MihaelaGadzhalova707/Diploma_Work/Presentation.pptx

## Автоматизация на аквариум

Представена от
Михаела Гаджалова
12б клас

## Идея на проекта

- Какъв проблем решава?
- Какво покрива?
- С какво е по-добро от това на пазара?

## От къде дойде идеята?

- Кафемашината по КАРХ
- Проект, свързан с автоматизацията на дома
- Моите домашни рибки

## Блокова схема на проекта

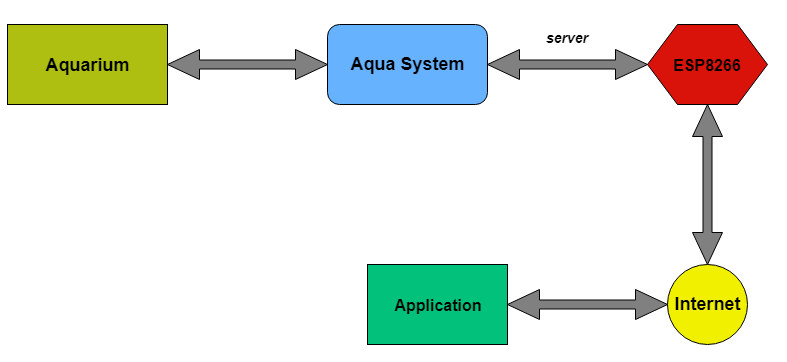
[picture p1: figure]

## Механика на помпата и клапаните

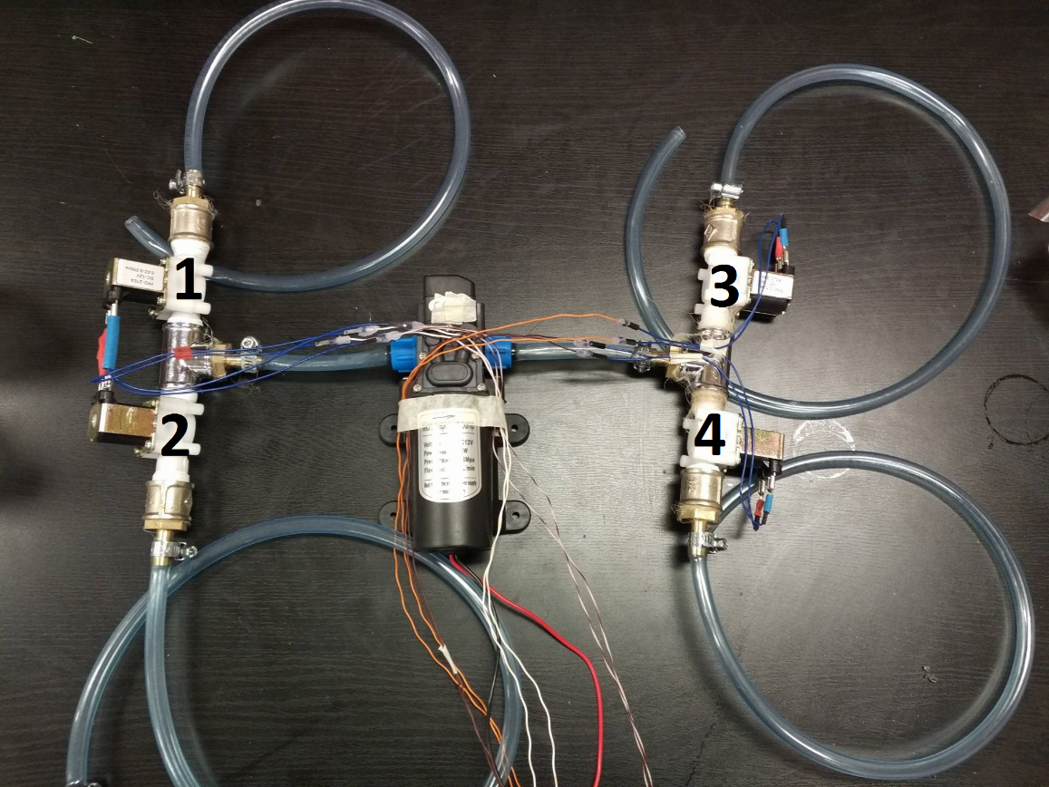
[picture p2: figure]
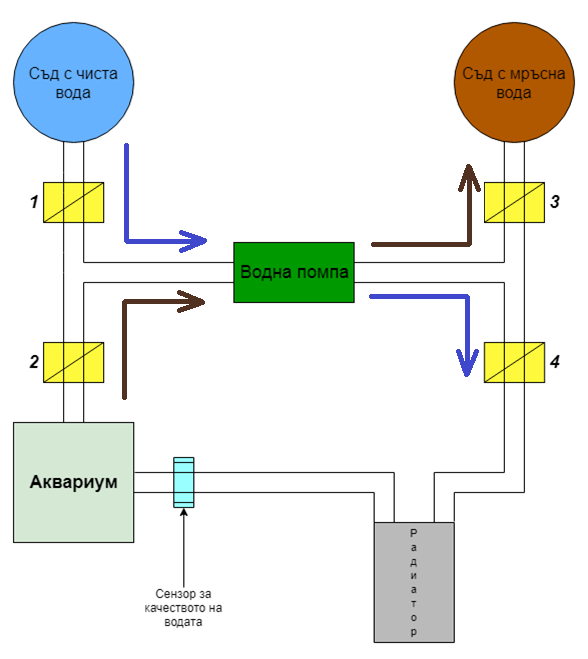
[picture p3: figure]

## Принципни електрически схеми

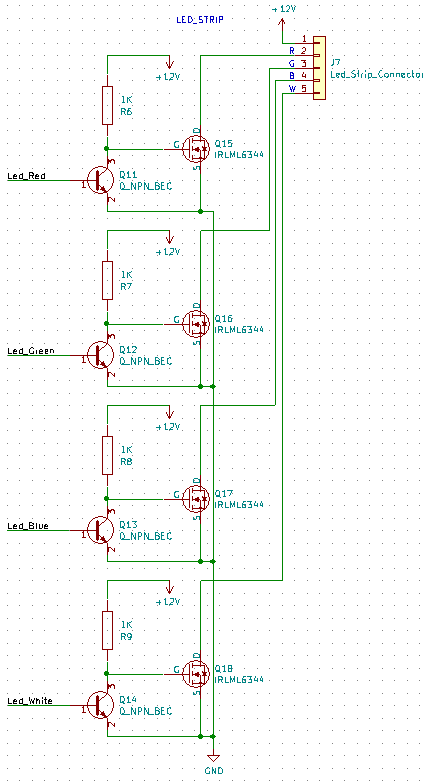
[picture p4: figure]

Светодиодна лента

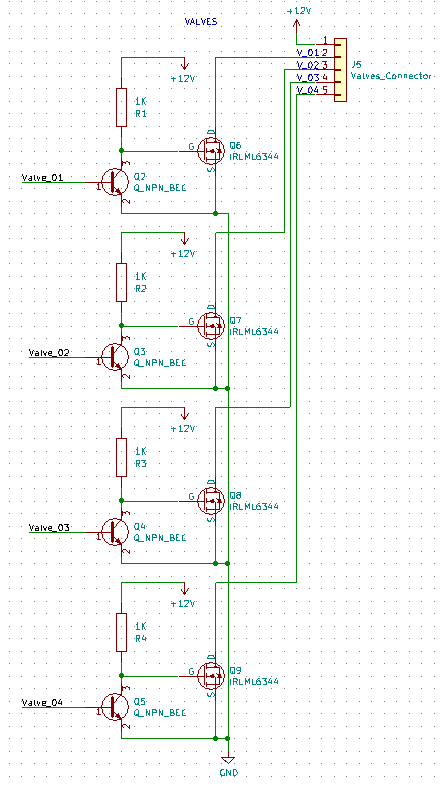
[picture p5: figure]

Клапани

## Принципни електрически схеми

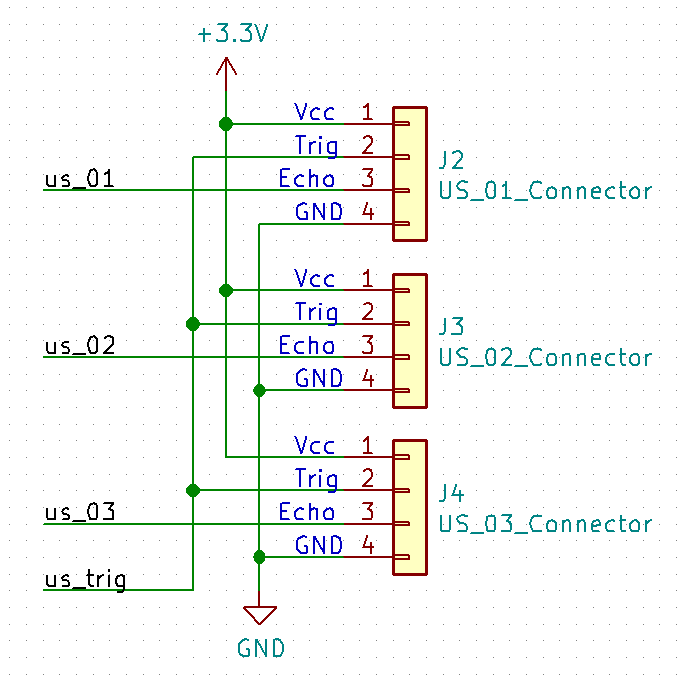
[picture p6: figure]

Ултразвукови сензори

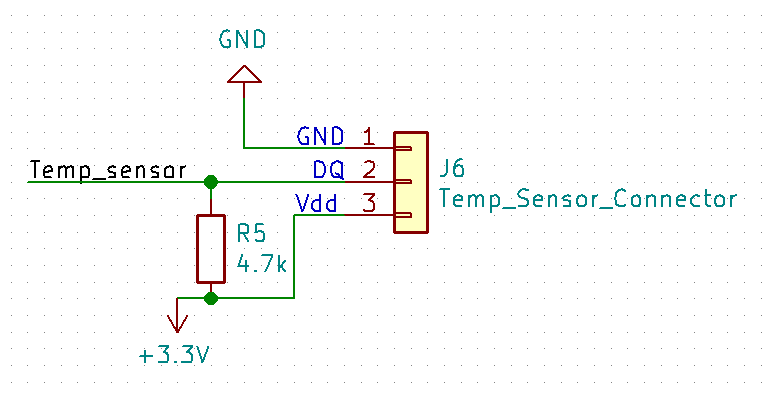
[picture p7: figure]

Сензор за температурата

## Графичен оригинал на печатната платка

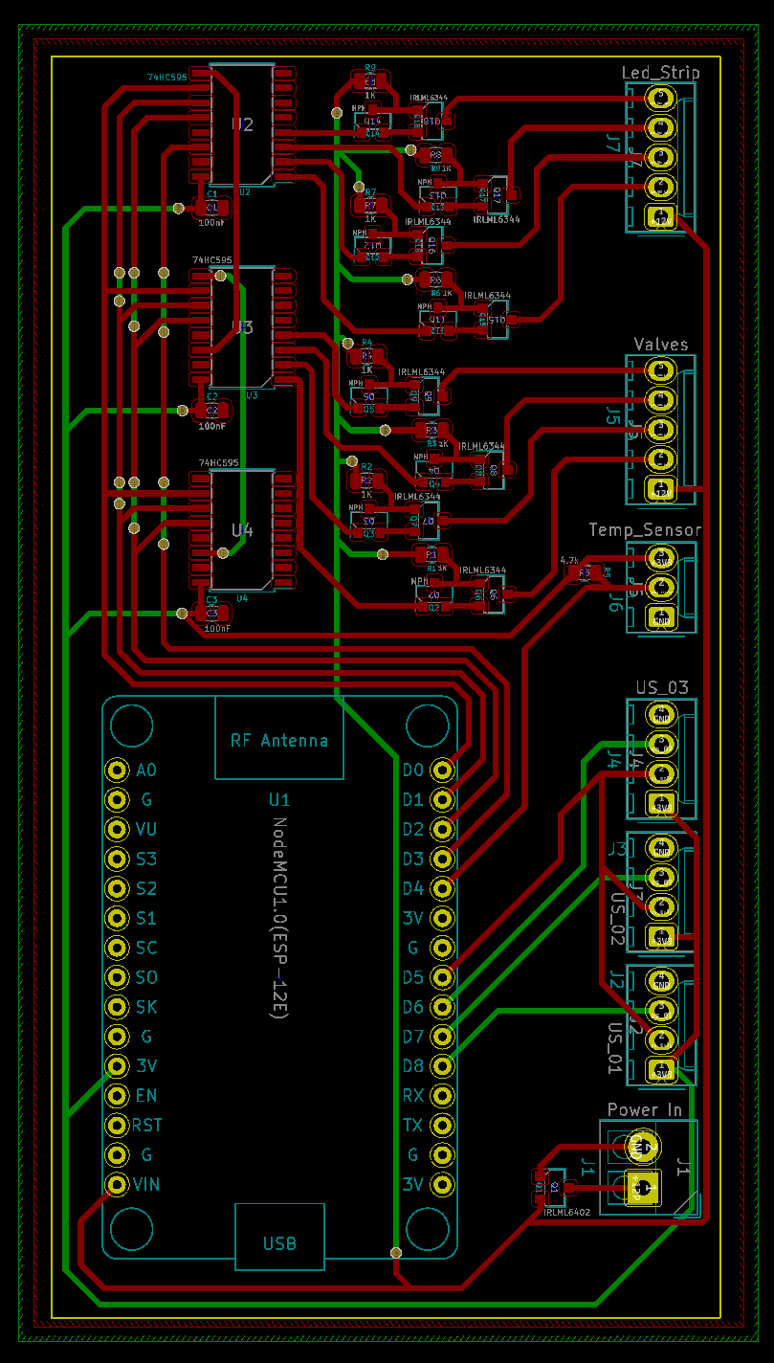
[picture p8: figure]
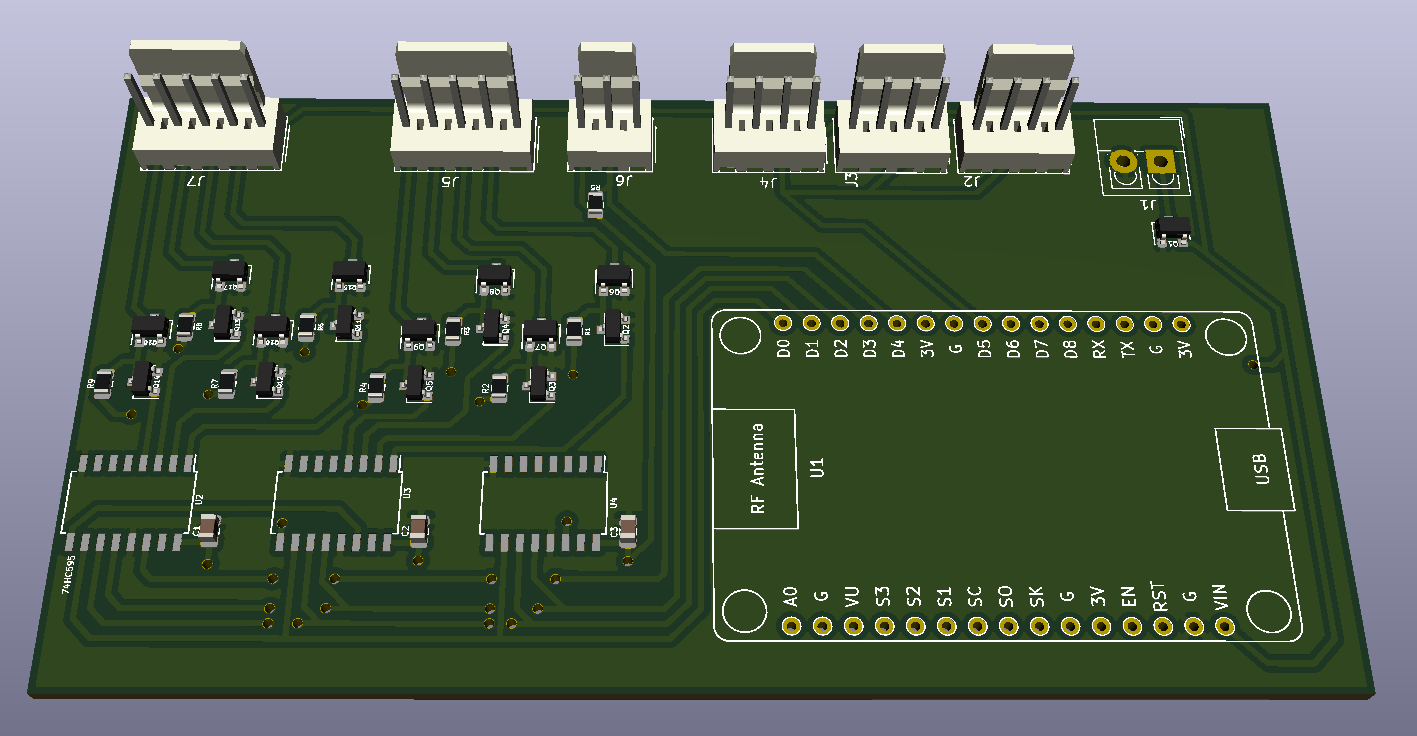
[picture p9: figure]

3D View

## Блокова схема на софтуера

## Свързване с хардуера

## Възникнали проблеми

- Слабо налягане на първата помпа
- Влизане на въдух по маркучите към помпата
- Стабилизиране на ултразвуковите сензори
- Изгорял микроконтролер
- Изгаряне на първата платка

## Бъдещо развитие

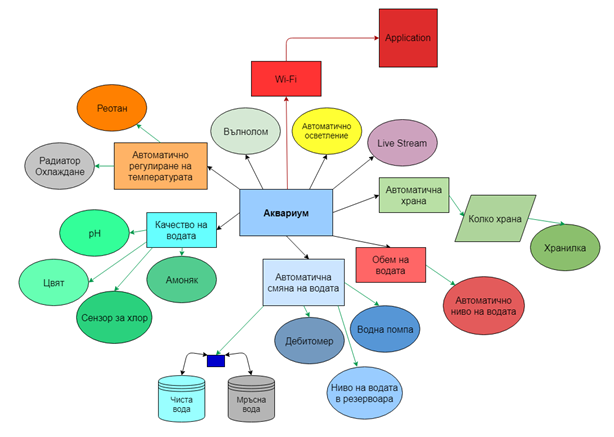
[picture p10: figure]

- Автоматизирана хранилка
- Следене качеството на водата
- Следене pH
- Затопляне на водата
- Live stream

## Slide 13

ДЕМО
