MihaelaGadzhalova707/Diploma_Work/shema/shema.kicad_pcb

## KiCad design shema/shema.kicad_pcb (2019-04-17)

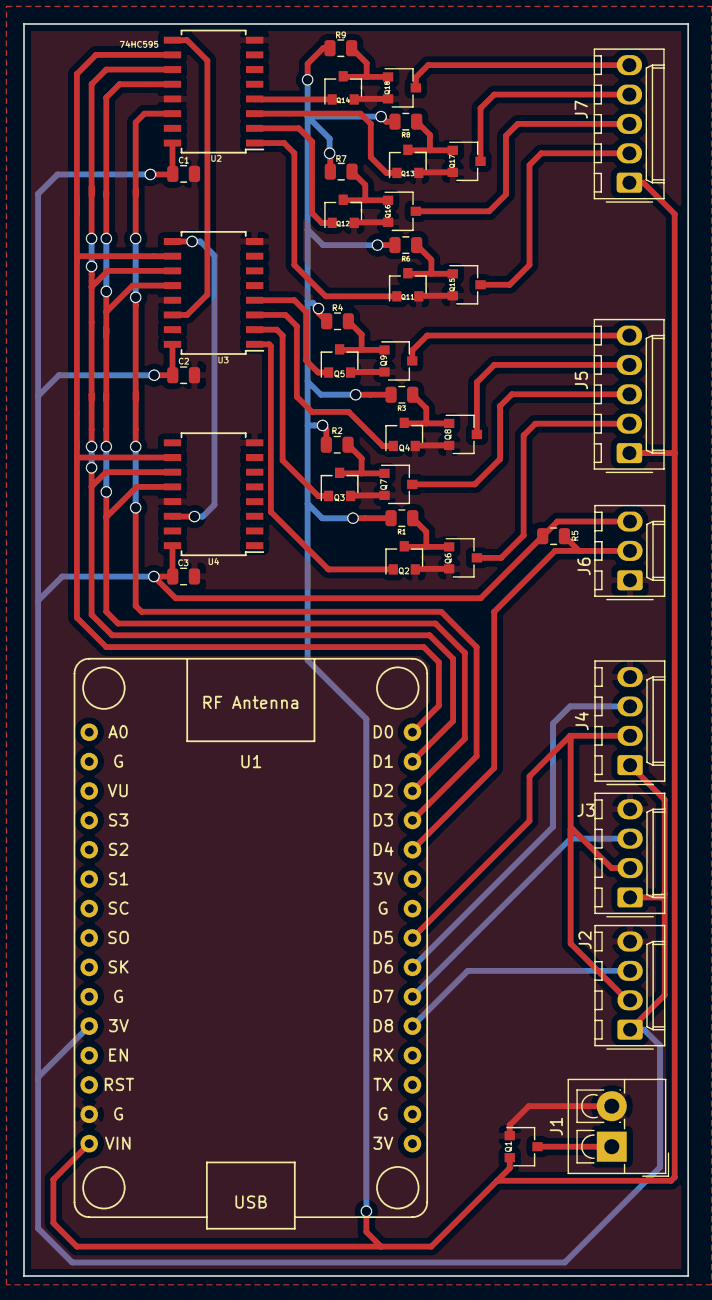
[picture p11: board shema.kicad_pcb from above]

Board: 2 copper layers, 57.4 x 108.2 mm, 40 parts (0 on the bottom side), 39 nets.

Parts:
C1, C2, C3: 100nF; C_0805_2012Metric
J1: Power In; TerminalBlock_4Ucon_1x02_P3.50mm_Vertical
J2: US_01; Molex_KK-254_AE-6410-04A_1x04_P2.54mm_Vertical
J3: US_02; Molex_KK-254_AE-6410-04A_1x04_P2.54mm_Vertical
J4: US_03; Molex_KK-254_AE-6410-04A_1x04_P2.54mm_Vertical
J5: Valves; Molex_KK-254_AE-6410-05A_1x05_P2.54mm_Vertical
J6: Temp_Sensor; Molex_KK-254_AE-6410-03A_1x03_P2.54mm_Vertical
J7: Led_Strip; Molex_KK-254_AE-6410-05A_1x05_P2.54mm_Vertical
Q1: IRLML6402; SC-59
Q2, Q3, Q4, Q5, Q11, Q12, Q13, Q14: NPN; SOT-23
Q6, Q7, Q8, Q9, Q15, Q16, Q17, Q18: IRLML6344; SC-59
R1, R2, R3, R4, R6, R7, R8, R9: 1K; R_0805_2012Metric
R5: 4.7k; R_0805_2012Metric
U1: NodeMCU1.0(ESP-12E); NodeMCU1.0(12-E)
U2, U3, U4: 74HC595; SOIC-16W_5.3x10.2mm_P1.27mm

Connections:
+3V3: C1.1, C2.2, C3.1, J2.1, J3.1, J4.1, J6.3, R5.2, U1.11, U2.16, U3.16, U4.16
+12P: J1.1, Q1.3
+12V: J5.1, J7.1, Q1.2, R1.1, R2.1, R3.1, R4.1, R6.1, R7.1, R8.1, R9.1, U1.15
/Led_Blue: Q13.1, U2.3
/Led_Green: Q12.1, U2.2
/Led_Red: Q11.1, U2.1
/Led_White: Q14.1, U2.4
/Temp_sensor: J6.2, R5.1, U1.26
/Valve_01: Q2.1, U3.1
/Valve_02: Q3.1, U3.2
/Valve_03: Q4.1, U3.3
/Valve_04: Q5.1, U3.4
/us_01: J2.3, U1.20
/us_02: J3.3, U1.21
/us_03: J4.3, U1.22
/us_trig: J2.2, J3.2, J4.2, U1.23
GND: C1.2, C2.1, C3.2, J1.2, J2.4, J3.4, J4.4, J6.1, Q1.1, Q2.2, Q3.2, Q4.2, Q5.2, Q6.2, Q7.2, Q8.2, Q9.2, Q11.2, Q12.2, Q13.2, Q14.2, Q15.2, Q16.2, Q17.2, Q18.2, U1.14, U2.8, U2.13, U3.8, U3.13, U4.8, U4.13
unnamed: J5.2, Q6.3
unnamed: J5.3, Q7.3
unnamed: J5.4, Q8.3
unnamed: J5.5, Q9.3
unnamed: J7.2, Q15.3
unnamed: J7.3, Q16.3
unnamed: J7.4, Q17.3
unnamed: J7.5, Q18.3
unnamed: Q2.3, Q6.1, R1.2
unnamed: Q3.3, Q7.1, R2.2
unnamed: Q4.3, Q8.1, R3.2
unnamed: Q5.3, Q9.1, R4.2
unnamed: Q11.3, Q15.1, R6.2
unnamed: Q12.3, Q16.1, R7.2
unnamed: Q13.3, Q17.1, R8.2
unnamed: Q14.3, Q18.1, R9.2
unnamed: U1.27, U2.14
unnamed: U1.28, U2.12, U3.12, U4.12
unnamed: U1.29, U2.11, U3.11, U4.11
unnamed: U1.30, U2.10, U3.10, U4.10
unnamed: U2.9, U3.14
unnamed: U3.9, U4.14
