MihaelaGadzhalova707/Diploma_Work/(commit log)

2018-12-14 Led Strip Shema
    [shema.kicad_pcb, shema.sch]
2019-03-12 first steps
    [shema.kicad_pcb, shema.sch]
2019-03-16 temp sensor pcb
    [shema.kicad_pcb, shema.sch]
2019-03-21 second version
    [shema.kicad_pcb, shema.sch]
2019-03-25 fixed names
    [shema.kicad_pcb]
2019-03-31 arduino codes
2019-04-01 working temperature sensor
2019-04-01 working temp sensor
2019-04-17 arduino web server
    [shema.kicad_pcb, shema.sch]
2019-04-19 sensors, temp and led
